tariqrm/Maverick/(list of files, drawings)

Other design files:
EasyEDA files/1-PCB_Design1.json
EasyEDA files/1-Schematic_robofest24.json
