tariqrm/Maverick/Sourcecode/Core/Src/main.c

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
/* Includes ------------------------------------------------------------------*/
#include "main.h"

/* USER CODE BEGIN Includes */
#include "stdio.h"
#include "stdbool.h"
#include "ssd1306.h"
#include "fonts.h"
#include "math.h"
#include "stdio.h"

#include "Pins.h"
#include "ZlgoVariables.h"
#include "Variables.h"
#include "Tof.h"
#include "Motors.h"
#include "Turns.h"
#include "WallPid.h"
#include "Speed.h"
#include "Moves.h"
#include "Zlgo.h"
#include "MazeSolve.h"

/* USER CODE END Includes */

/* USER CODE BEGIN PM */
QueueArray* queue = NULL;
QueueArray* pathQueue = NULL;
/* USER CODE END PM */

I2C_HandleTypeDef hi2c1;

TIM_HandleTypeDef htim4;

UART_HandleTypeDef huart2;

void SystemClock_Config(void);
static void MX_GPIO_Init(void);
static void MX_USART2_UART_Init(void);
static void MX_I2C1_Init(void);
static void MX_TIM4_Init(void);
/**
  * @brief  The application entry point.
  * @retval int
  */
int main(void)
{

  /* MCU Configuration--------------------------------------------------------*/

  /* Reset of all peripherals, Initializes the Flash interface and the Systick. */
  HAL_Init();

  /* Configure the system clock */
  SystemClock_Config();

  /* Initialize all configured peripherals */
  MX_GPIO_Init();
  MX_USART2_UART_Init();
  MX_I2C1_Init();
  MX_TIM4_Init();
  /* USER CODE BEGIN 2 */

  HAL_TIM_PWM_Start(&htim4, TIM_CHANNEL_3);
  HAL_TIM_PWM_Start(&htim4, TIM_CHANNEL_4);

  queue = QueueArray_create(256);
  pathQueue = QueueArray_create(256);

  /* USER CODE END 2 */

  /* Infinite loop */
  /* USER CODE BEGIN WHILE */
  while (1)
  {
	  printf("Hello from STM32 via HC-05!\r\n");
	  HAL_Delay(1000);
	  searchStates();

    /* USER CODE END WHILE */

    /* USER CODE BEGIN 3 */
  }
  /* USER CODE END 3 */
}

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
/* USER CODE BEGIN 4 */

int _write(int file, char *ptr, int len) {
    HAL_UART_Transmit(&huart2, (uint8_t*)ptr, len, HAL_MAX_DELAY);
    return len;
}


/* USER CODE END 4 */
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
