tariqrm/Maverick/Sourcecode/Core/Inc/main.h

#define INT_LED_Pin GPIO_PIN_13
#define INT_LED_GPIO_Port GPIOC
#define GPIO2_Pin GPIO_PIN_0
#define GPIO2_GPIO_Port GPIOA
#define GPIO1_Pin GPIO_PIN_1
#define GPIO1_GPIO_Port GPIOA
#define GPIO5_Pin GPIO_PIN_4
#define GPIO5_GPIO_Port GPIOA
#define GPIO3_Pin GPIO_PIN_5
#define GPIO3_GPIO_Port GPIOA
#define GPIO4_Pin GPIO_PIN_6
#define GPIO4_GPIO_Port GPIOA
#define AIN2_Pin GPIO_PIN_7
#define AIN2_GPIO_Port GPIOA
#define BIN1_Pin GPIO_PIN_0
#define BIN1_GPIO_Port GPIOB
#define BIN2_Pin GPIO_PIN_1
#define BIN2_GPIO_Port GPIOB
#define SWITCH_Pin GPIO_PIN_8
#define SWITCH_GPIO_Port GPIOA
#define STBY_Pin GPIO_PIN_11
#define STBY_GPIO_Port GPIOA
#define AIN1_Pin GPIO_PIN_12
#define AIN1_GPIO_Port GPIOA
#define BUZZER_Pin GPIO_PIN_5
#define BUZZER_GPIO_Port GPIOB
#define PWMA_Pin GPIO_PIN_8
#define PWMA_GPIO_Port GPIOB
#define PWMB_Pin GPIO_PIN_9
#define PWMB_GPIO_Port GPIOB
