tariqrm/Maverick/Sourcecode/Core/Inc/Turns.h

/*
 * Turns.h
 *
 *  Created on: Mar 20, 2025
 *      Author: tmuth
 */

#ifndef INC_TURNS_H_
#define INC_TURNS_H_

void countLeftOut1()
{
    leftEncoder = leftEncoder + 1;
}

void countRightOut1()
{
    rightEncoder = rightEncoder + 1;
}

void turnBack()
{
    encoderLeftCount = 0;
    encoderRightCount = 0;
    leftEncoder = 0;
    rightEncoder = 0;
    encoderRightCount= encoderRightCount + 100;
    encoderLeftCount= encoderLeftCount + 100;
    while (rightEncoder <= encoderRightCount || leftEncoder <= encoderLeftCount)
    {
        dif = leftEncoder - encoderLeftCount + 100;
        rightBase = (int)(70+110/(1+pow(2.73,((50-dif)*0.05))));
        leftBase = (int)(70+110/(1+pow(2.73,((50-dif)*0.05))));
        turnRight();
    }
    rightBase=176;
    leftBase=180;
    encoderRightCount= encoderRightCount + 750;
    encoderLeftCount= encoderLeftCount + 750;
    while(rightEncoder <= encoderRightCount || leftEncoder <= encoderLeftCount)
    {
        turnRight();
    }
    encoderRightCount= encoderRightCount + 100;
    encoderLeftCount= encoderLeftCount + 100;
    while (rightEncoder <= encoderRightCount || leftEncoder <= encoderLeftCount)
    {
        dif = leftEncoder - encoderLeftCount + 100;
        rightBase = (int)(176-110/(1+pow(2.73,((50-dif)*0.05))));
        leftBase = (int)(180-110/(1+pow(2.73,((50-dif)*0.05))));
        turnRight();
    }
    brake();
    leftBase = 180;
    rightBase = 176;
    encoderLeftCount = 0;
    encoderRightCount = 0;
    leftEncoder = 0;
    rightEncoder = 0;
}

void rightAboutTurn()
{
    encoderLeftCount = 0;
    encoderRightCount = 0;
    leftEncoder = 0;
    rightEncoder = 0;
    encoderRightCount= encoderRightCount + 100;
    encoderLeftCount= encoderLeftCount + 100;
    rightBase = 70;
    leftBase = 70;
    while (rightEncoder <= encoderRightCount || leftEncoder <= encoderLeftCount)
    {
        dif = leftEncoder - encoderLeftCount + 100;
        rightBase = (int)(70+110/(1+pow(2.73,((50-dif)*0.05))));
        leftBase = (int)(70+110/(1+pow(2.73,((50-dif)*0.05))));
        turnRight();
    }
    rightBase=176;
    leftBase=180;
    encoderRightCount= encoderRightCount + 270;
    encoderLeftCount= encoderLeftCount + 270;
    while(rightEncoder <= encoderRightCount)
    {
        turnRight();
    }
    encoderRightCount= encoderRightCount + 100;
    encoderLeftCount= encoderLeftCount + 100;
    while (rightEncoder <= encoderRightCount || leftEncoder <= encoderLeftCount)
    {
        dif = leftEncoder - encoderLeftCount + 100;
        rightBase = (int)(176-110/(1+pow(2.73,((50-dif)*0.05))));
        leftBase = (int)(180-110/(1+pow(2.73,((50-dif)*0.05))));
        turnRight();
    }
    brake();
    leftBase = 180;
    rightBase = 176;
    encoderLeftCount = 0;
    encoderRightCount = 0;
    leftEncoder = 0;
    rightEncoder = 0;
}

void leftAboutTurn()
{
    encoderLeftCount = 0;
    encoderRightCount = 0;
    leftEncoder = 0;
    rightEncoder = 0;
    rightBase = 70;
    leftBase = 70;
    encoderRightCount= encoderRightCount + 100;
    encoderLeftCount= encoderLeftCount + 100;
    while (rightEncoder <= encoderRightCount || leftEncoder <= encoderLeftCount)
    {
        dif = leftEncoder - encoderLeftCount + 100;
        rightBase = (int)(70+110/(1+pow(2.73,((50-dif)*0.05))));
        leftBase = (int)(70+110/(1+pow(2.73,((50-dif)*0.05))));
        turnLeft();
    }
    rightBase=176;
    leftBase=180;
    encoderRightCount= encoderRightCount + 240; //255
    encoderLeftCount= encoderLeftCount + 240;   //255
    while(rightEncoder <= encoderRightCount)
    {
        turnLeft();
    }

    encoderRightCount= encoderRightCount + 100;
    encoderLeftCount= encoderLeftCount + 100;
    while (rightEncoder <= encoderRightCount || leftEncoder <= encoderLeftCount)
    {
        dif = leftEncoder - encoderLeftCount + 100;
        rightBase = (int)(176-110/(1+pow(2.73,((50-dif)*0.05))));
        leftBase = (int)(180-110/(1+pow(2.73,((50-dif)*0.05))));
        turnLeft();
    }
    brake();
    leftBase = 180;
    rightBase = 176;
    encoderLeftCount = 0;
    encoderRightCount = 0;
    leftEncoder = 0;
    rightEncoder = 0;
}

void rightHalfTurn()
{
    encoderLeftCount = 0;
    encoderRightCount = 0;
    leftEncoder = 0;
    rightEncoder = 0;
    encoderRightCount= encoderRightCount + 100;
    encoderLeftCount= encoderLeftCount + 100;
    rightBase = 70;
    leftBase = 70;
    while (rightEncoder <= encoderRightCount || leftEncoder <= encoderLeftCount)
    {
        dif = leftEncoder - encoderLeftCount + 100;
        rightBase = (int)(70+110/(1+pow(2.73,((50-dif)*0.05))));
        leftBase = (int)(70+110/(1+pow(2.73,((50-dif)*0.05))));
        turnRight();
    }
    rightBase=176;
    leftBase=180;
    encoderRightCount= encoderRightCount + 1;
    encoderLeftCount= encoderLeftCount + 1;
    while(rightEncoder <= encoderRightCount)
    {
        turnRight();
    }
    encoderRightCount= encoderRightCount + 100;
    encoderLeftCount= encoderLeftCount + 100;
    while (rightEncoder <= encoderRightCount || leftEncoder <= encoderLeftCount)
    {
        dif = leftEncoder - encoderLeftCount + 100;
        rightBase = (int)(176-110/(1+pow(2.73,((50-dif)*0.05))));
        leftBase = (int)(180-110/(1+pow(2.73,((50-dif)*0.05))));
        turnRight();
    }
    brake();
    leftBase = 180;
    rightBase = 176;
    encoderLeftCount = 0;
    encoderRightCount = 0;
    leftEncoder = 0;
    rightEncoder = 0;
}


#endif /* INC_TURNS_H_ */
