tariqrm/Maverick/Sourcecode/Core/Inc/ZlgoVariables.h

/*
 * ZlgoVariables.h
 *
 *  Created on: Mar 20, 2025
 *      Author: tmuth
 */

#ifndef INC_ZLGOVARIABLES_H_
#define INC_ZLGOVARIABLES_H_

#include "QueueArray.h"

uint8_t x=0;
uint8_t y=0;

uint8_t xprev=0;
uint8_t yprev=0;
uint8_t orient=0;
uint8_t state=0;
bool shortPath= false;
bool middleSquare= true;
uint8_t x_0;
uint8_t y_0;
uint8_t x_1;
uint8_t y_1;
uint8_t x_2;
uint8_t y_2;
uint8_t x_3;
uint8_t y_3;
uint8_t mazeSize = 16;
char dir;
char turning;

//QueueArray* queue = QueueArray_create(256);
//QueueArray* pathQueue = QueueArray_create(256);

extern QueueArray* queue;
extern QueueArray* pathQueue;

bool  L = true;
bool  R= true;
bool  F= false;
uint8_t xdes;
uint8_t ydes;
unsigned long timer;
int cellCount =0;
bool runningNext;

uint8_t cells[16][16] = {
        {0,0,0,0,0,0,0,0,0,0,0,0,0,0,0,0},
        {0,0,0,0,0,0,0,0,0,0,0,0,0,0,0,0},
        {0,0,0,0,0,0,0,0,0,0,0,0,0,0,0,0},
        {0,0,0,0,0,0,0,0,0,0,0,0,0,0,0,0},
        {0,0,0,0,0,0,0,0,0,0,0,0,0,0,0,0},
        {0,0,0,0,0,0,0,0,0,0,0,0,0,0,0,0},
        {0,0,0,0,0,0,0,0,0,0,0,0,0,0,0,0},
        {0,0,0,0,0,0,0,0,0,0,0,0,0,0,0,0},
        {0,0,0,0,0,0,0,0,0,0,0,0,0,0,0,0},
        {0,0,0,0,0,0,0,0,0,0,0,0,0,0,0,0},
        {0,0,0,0,0,0,0,0,0,0,0,0,0,0,0,0},
        {0,0,0,0,0,0,0,0,0,0,0,0,0,0,0,0},
        {0,0,0,0,0,0,0,0,0,0,0,0,0,0,0,0},
        {0,0,0,0,0,0,0,0,0,0,0,0,0,0,0,0},
        {0,0,0,0,0,0,0,0,0,0,0,0,0,0,0,0},
        {0,0,0,0,0,0,0,0,0,0,0,0,0,0,0,0}
      };

uint8_t flood2[16][16] = {
        {0,0,0,0,0,0,0,0,0,0,0,0,0,0,0,0},
        {0,0,0,0,0,0,0,0,0,0,0,0,0,0,0,0},
        {0,0,0,0,0,0,0,0,0,0,0,0,0,0,0,0},
        {0,0,0,0,0,0,0,0,0,0,0,0,0,0,0,0},
        {0,0,0,0,0,0,0,0,0,0,0,0,0,0,0,0},
        {0,0,0,0,0,0,0,0,0,0,0,0,0,0,0,0},
        {0,0,0,0,0,0,0,0,0,0,0,0,0,0,0,0},
        {0,0,0,0,0,0,0,0,0,0,0,0,0,0,0,0},
        {0,0,0,0,0,0,0,0,0,0,0,0,0,0,0,0},
        {0,0,0,0,0,0,0,0,0,0,0,0,0,0,0,0},
        {0,0,0,0,0,0,0,0,0,0,0,0,0,0,0,0},
        {0,0,0,0,0,0,0,0,0,0,0,0,0,0,0,0},
        {0,0,0,0,0,0,0,0,0,0,0,0,0,0,0,0},
        {0,0,0,0,0,0,0,0,0,0,0,0,0,0,0,0},
        {0,0,0,0,0,0,0,0,0,0,0,0,0,0,0,0},
        {0,0,0,0,0,0,0,0,0,0,0,0,0,0,0,0}
      };

uint8_t flood[16][16] = {
        {14,13,12,11,10,9,8,7,7,8,9,10,11,12,13,14},
        {13,12,11,10,9,8,7,6,6,7,8,9,10,11,12,13},
        {12,11,10,9,8,7,6,5,5,6,7,8,9,10,11,12},
        {11,10,9,8,7,6,5,4,4,5,6,7,8,9,10,11},
        {10,9,8,7,6,5,4,3,3,4,5,6,7,8,9,10},
        {9,8,7,6,5,4,3,2,2,3,4,5,6,7,8,9},
        {8,7,6,5,4,3,2,1,1,2,3,4,5,6,7,8},
        {7,6,5,4,3,2,1,0,0,1,2,3,4,5,6,7},
        {7,6,5,4,3,2,1,0,0,1,2,3,4,5,6,7},
        {8,7,6,5,4,3,2,1,1,2,3,4,5,6,7,8},
        {9,8,7,6,5,4,3,2,2,3,4,5,6,7,8,9},
        {10,9,8,7,6,5,4,3,3,4,5,6,7,8,9,10},
        {11,10,9,8,7,6,5,4,4,5,6,7,8,9,10,11},
        {12,11,10,9,8,7,6,5,5,6,7,8,9,10,11,12},
        {13,12,11,10,9,8,7,6,6,7,8,9,10,11,12,13},
        {14,13,12,11,10,9,8,7,7,8,9,10,11,12,13,14}
      };

char bluetoothWalls;
uint8_t xrun=0;
uint8_t yrun=0;



#endif /* INC_ZLGOVARIABLES_H_ */
